VANTHO15/Drone_ThuyetTrinh/Tài nguyên/003 BV máy tổng thể.pdf

Tỷ lệ: 1:2 THIẾT KẾ, CHẾ TẠO MÁY TRỢ THỞ PHỤC VỤ COVID-19 Hướng dẫn Thiết kế T.Nhiệm Họ và tên Ngày Ký ĐỒ ÁN TỐT NGHIỆP Khối lượng: Tờ số: 5 Số tờ: Duyệt Hồ Hữu Bền TS. Hoàng Văn Thạnh Phạm Hồng Vinh TT Ký hiệu Tên gọi Số lượng Klg Vật liệu Ghi chú 0102030405 Nút nguồn Nút điều khiển Đèn tín hiệu KHOA CƠ KHÍ - LỚP 16C1A BẢN VẼ MÁY 12 3 4 5 6 7 0607 Ống nối thở ra Ống nối hít vào 8 08 Ống nối nguồn khí Oxy 0103020501010101 Volume điều chỉnh Van PEEP 370 280

### 300 TRƯỜNG ĐHBK- ĐH ĐÀ NẴNG 6 PGS.TS. Lưu Đức Bình

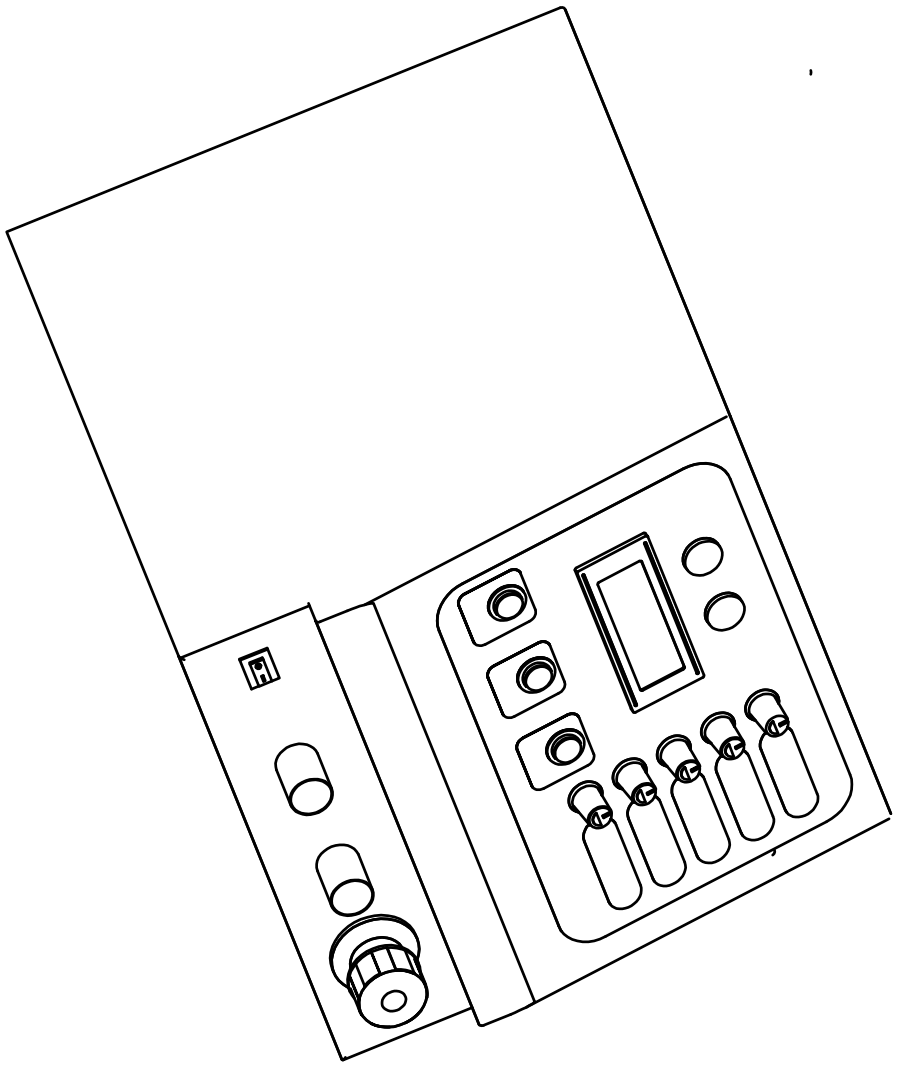
[picture p47: figure]
