VANTHO15/Drone_ThuyetTrinh/Tài nguyên/005 BV lắp.pdf

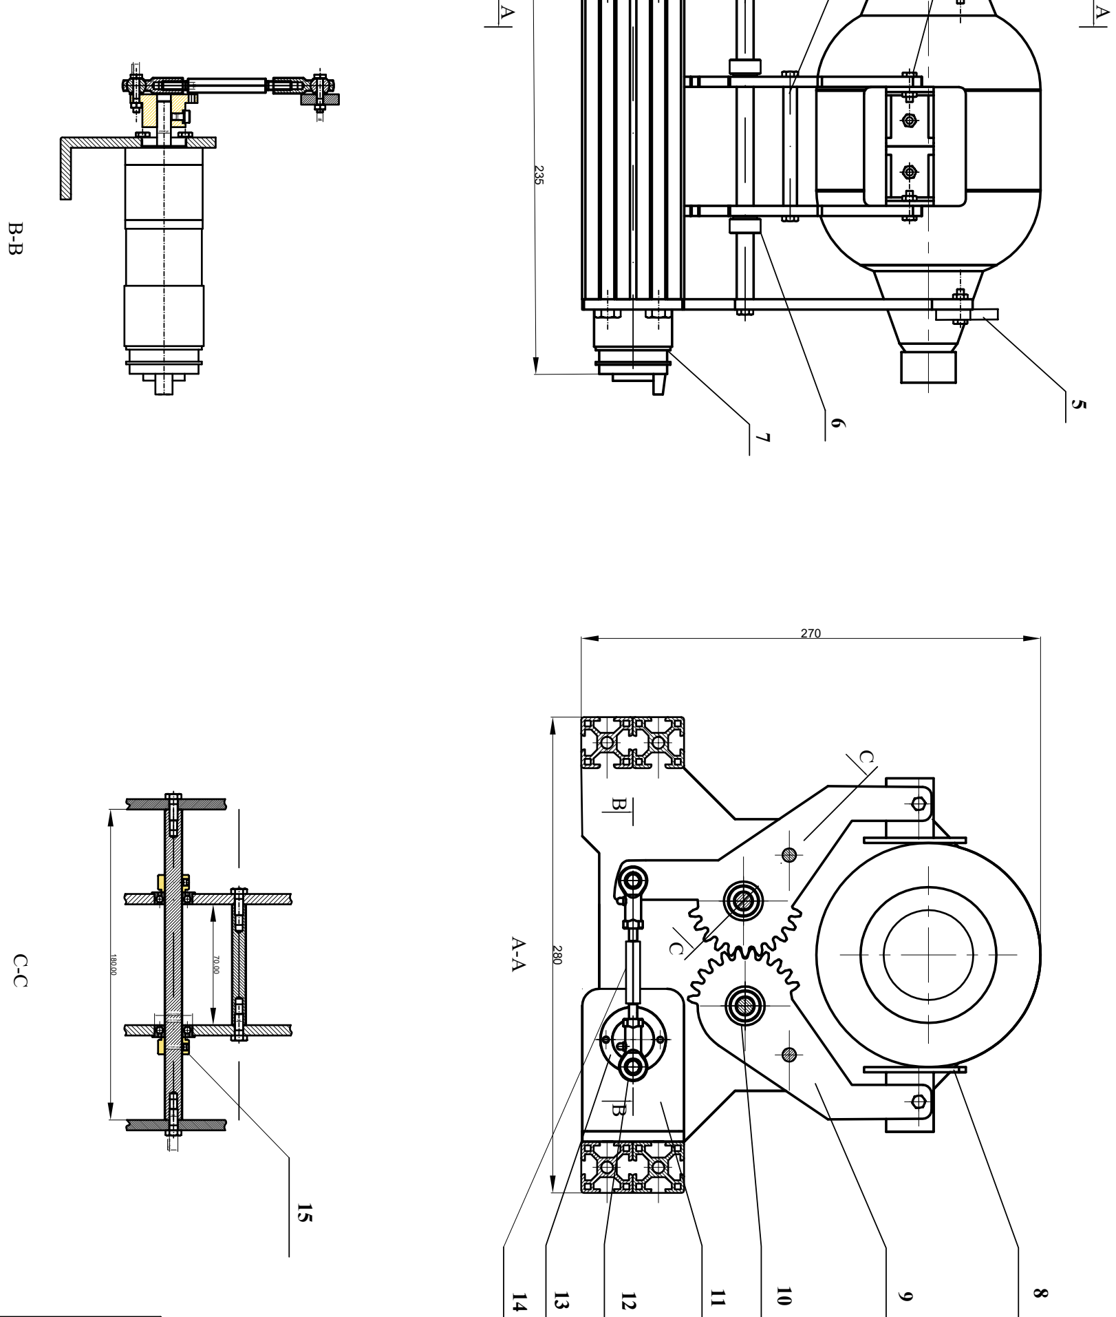
[picture p48: figure]

A-A Tỷ lệ: 1:1 THIẾT KẾ, CHẾ TẠO MÁY TRỢ THỞ PHỤC VỤ COVID-19 Hướng dẫn Thiết kế T.Nhiệm Họ và tên Ngày Ký ĐỒ ÁN TỐT NGHIỆP Khối lượng: Tờ số: 4 Số tờ: Duyệt Hồ Hữu Bền TS. Hoàng Văn Thạnh Phạm Hồng Vinh TT Ký hiệu Tên gọi Số lượng Klg Vật liệu Ghi chú 0102030405 Má bóp Mặt bích KHOA CƠ KHÍ - LỚP 16C1A BẢN VẼ TỔNG THỂ Càng bóp Tấm kẹp Thanh truyền Vít M5 Khớp cầu Ổ lăn Trục ngắn Trục dài Giá đỡ động cơ 06070809101112131415 01 02040101 02 04120401 02 Nhôm Nhôm Thép Thép Thép Thép Thép Nhôm Thép Con chặn 04 Nhôm Động cơ 1

1
2

3

4

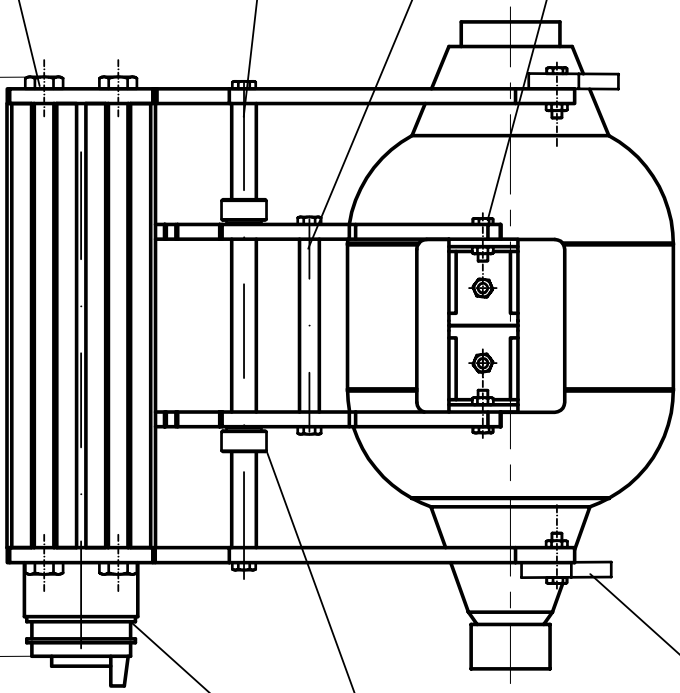
[picture p49: figure]

# 235 Vít M8 08 Thép Con chặn 04 Thép TRƯỜNG ĐHBK- ĐH ĐÀ NẴNG

# 6 PGS.TS. Lưu Đức Bình
