VANTHO15/Drone_ThuyetTrinh/(list of files, cad)

Other CAD files:
Tài nguyên/MachNguyenLyMayTho.dwg
Tài nguyên/00000001DATN.dwg
Tài nguyên/BẢN VẼ/BẢN VẼ/Bánh răng lớn.prt
Tài nguyên/BẢN VẼ/BẢN VẼ/Bánh răng nhỏ.prt
Tài nguyên/BẢN VẼ/BẢN VẼ/Gá mô tơ.prt
Tài nguyên/BẢN VẼ/BẢN VẼ/Khunglung.prt
Tài nguyên/BẢN VẼ/BẢN VẼ/Khunglungnho.prt
Tài nguyên/BẢN VẼ/BẢN VẼ/Lắp ráp.prt
Tài nguyên/BẢN VẼ/BẢN VẼ/Má bóp.prt
Tài nguyên/BẢN VẼ/BẢN VẼ/Mô tơ.prt
Tài nguyên/BẢN VẼ/BẢN VẼ/Nhom thanh.prt
Tài nguyên/BẢN VẼ/BẢN VẼ/con đỡ.prt
Tài nguyên/BẢN VẼ/BẢN VẼ/mặt bích.prt
Tài nguyên/BẢN VẼ/BẢN VẼ/thanh truyền.prt
Tài nguyên/BẢN VẼ/BẢN VẼ/truc ngăn.prt
Tài nguyên/BẢN VẼ/BẢN VẼ/trục dài.prt
Tài nguyên/BẢN VẼ/BẢN VẼ/vít M4.prt
Tài nguyên/BẢN VẼ/BẢN VẼ/vít m5.prt
Tài nguyên/Tải về/BẢN VẼ/Bánh răng lớn.prt
Tài nguyên/Tải về/BẢN VẼ/Bánh răng nhỏ.prt
Tài nguyên/Tải về/BẢN VẼ/File lung sau sửa.prt
Tài nguyên/Tải về/BẢN VẼ/File lưng 2 sau sửa.prt
Tài nguyên/Tải về/BẢN VẼ/Gá mô tơ.prt
Tài nguyên/Tải về/BẢN VẼ/Lắp ráp 01.prt
Tài nguyên/Tải về/BẢN VẼ/Má bóp.prt
Tài nguyên/Tải về/BẢN VẼ/Mô tơ.prt
Tài nguyên/Tải về/BẢN VẼ/Nhom thanh.prt
Tài nguyên/Tải về/BẢN VẼ/con đỡ.prt
Tài nguyên/Tải về/BẢN VẼ/mặt bích.prt
Tài nguyên/Tải về/BẢN VẼ/thanh truyền.prt
Tài nguyên/Tải về/BẢN VẼ/truc ngăn.prt
Tài nguyên/Tải về/BẢN VẼ/trục dài.prt
Tài nguyên/Tải về/BẢN VẼ/vít M4.prt
Tài nguyên/Tải về/BẢN VẼ/vít m5.prt
