VANTHO15/Drone_ThuyetTrinh/Tài nguyên/06 BV mạch điều khiển.pdf

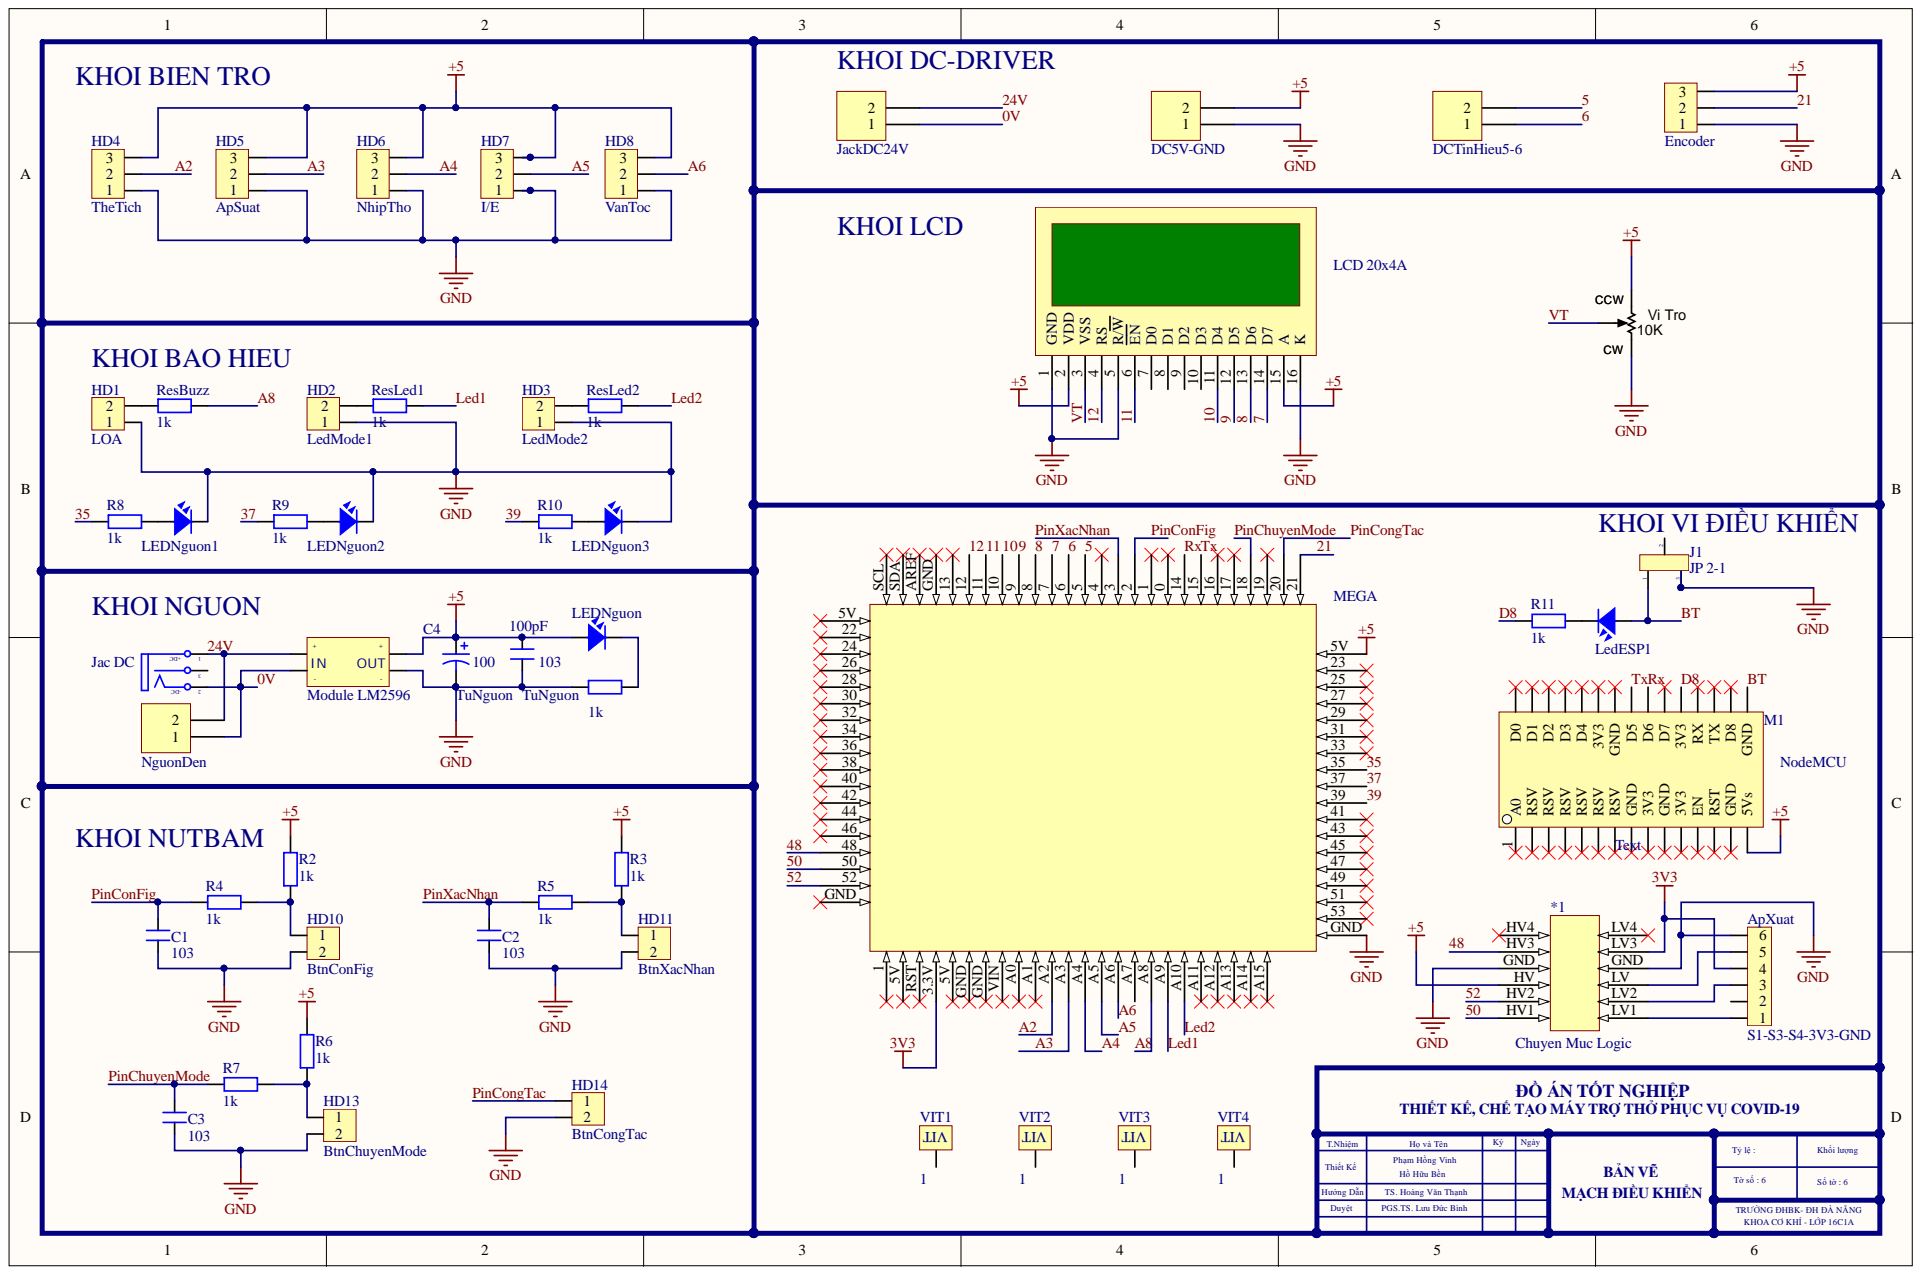
[picture p50: page 1]

KHOI VI ĐIỀU KHIỂN

GND | GND
HV | LV

ĐỒ ÁN TỐT NGHIỆP THIẾT KẾ, CHẾ TẠO MÁY TRỢ THỞ PHỤC VỤ COVID-19

TS. Hoàng Văn Thạnh

Duyệt | PGS.TS. Lưu Đức Bình | TRƯỜNG ĐHBK- ĐH ĐÀ NẴNG KHOA CƠ KHÍ - LỚP 16C1A
