VANTHO15/Drone_ThuyetTrinh/Tài nguyên/001 Bản vẽ chế tạoo.pdf

Ø4⁺⁰.1 19

160

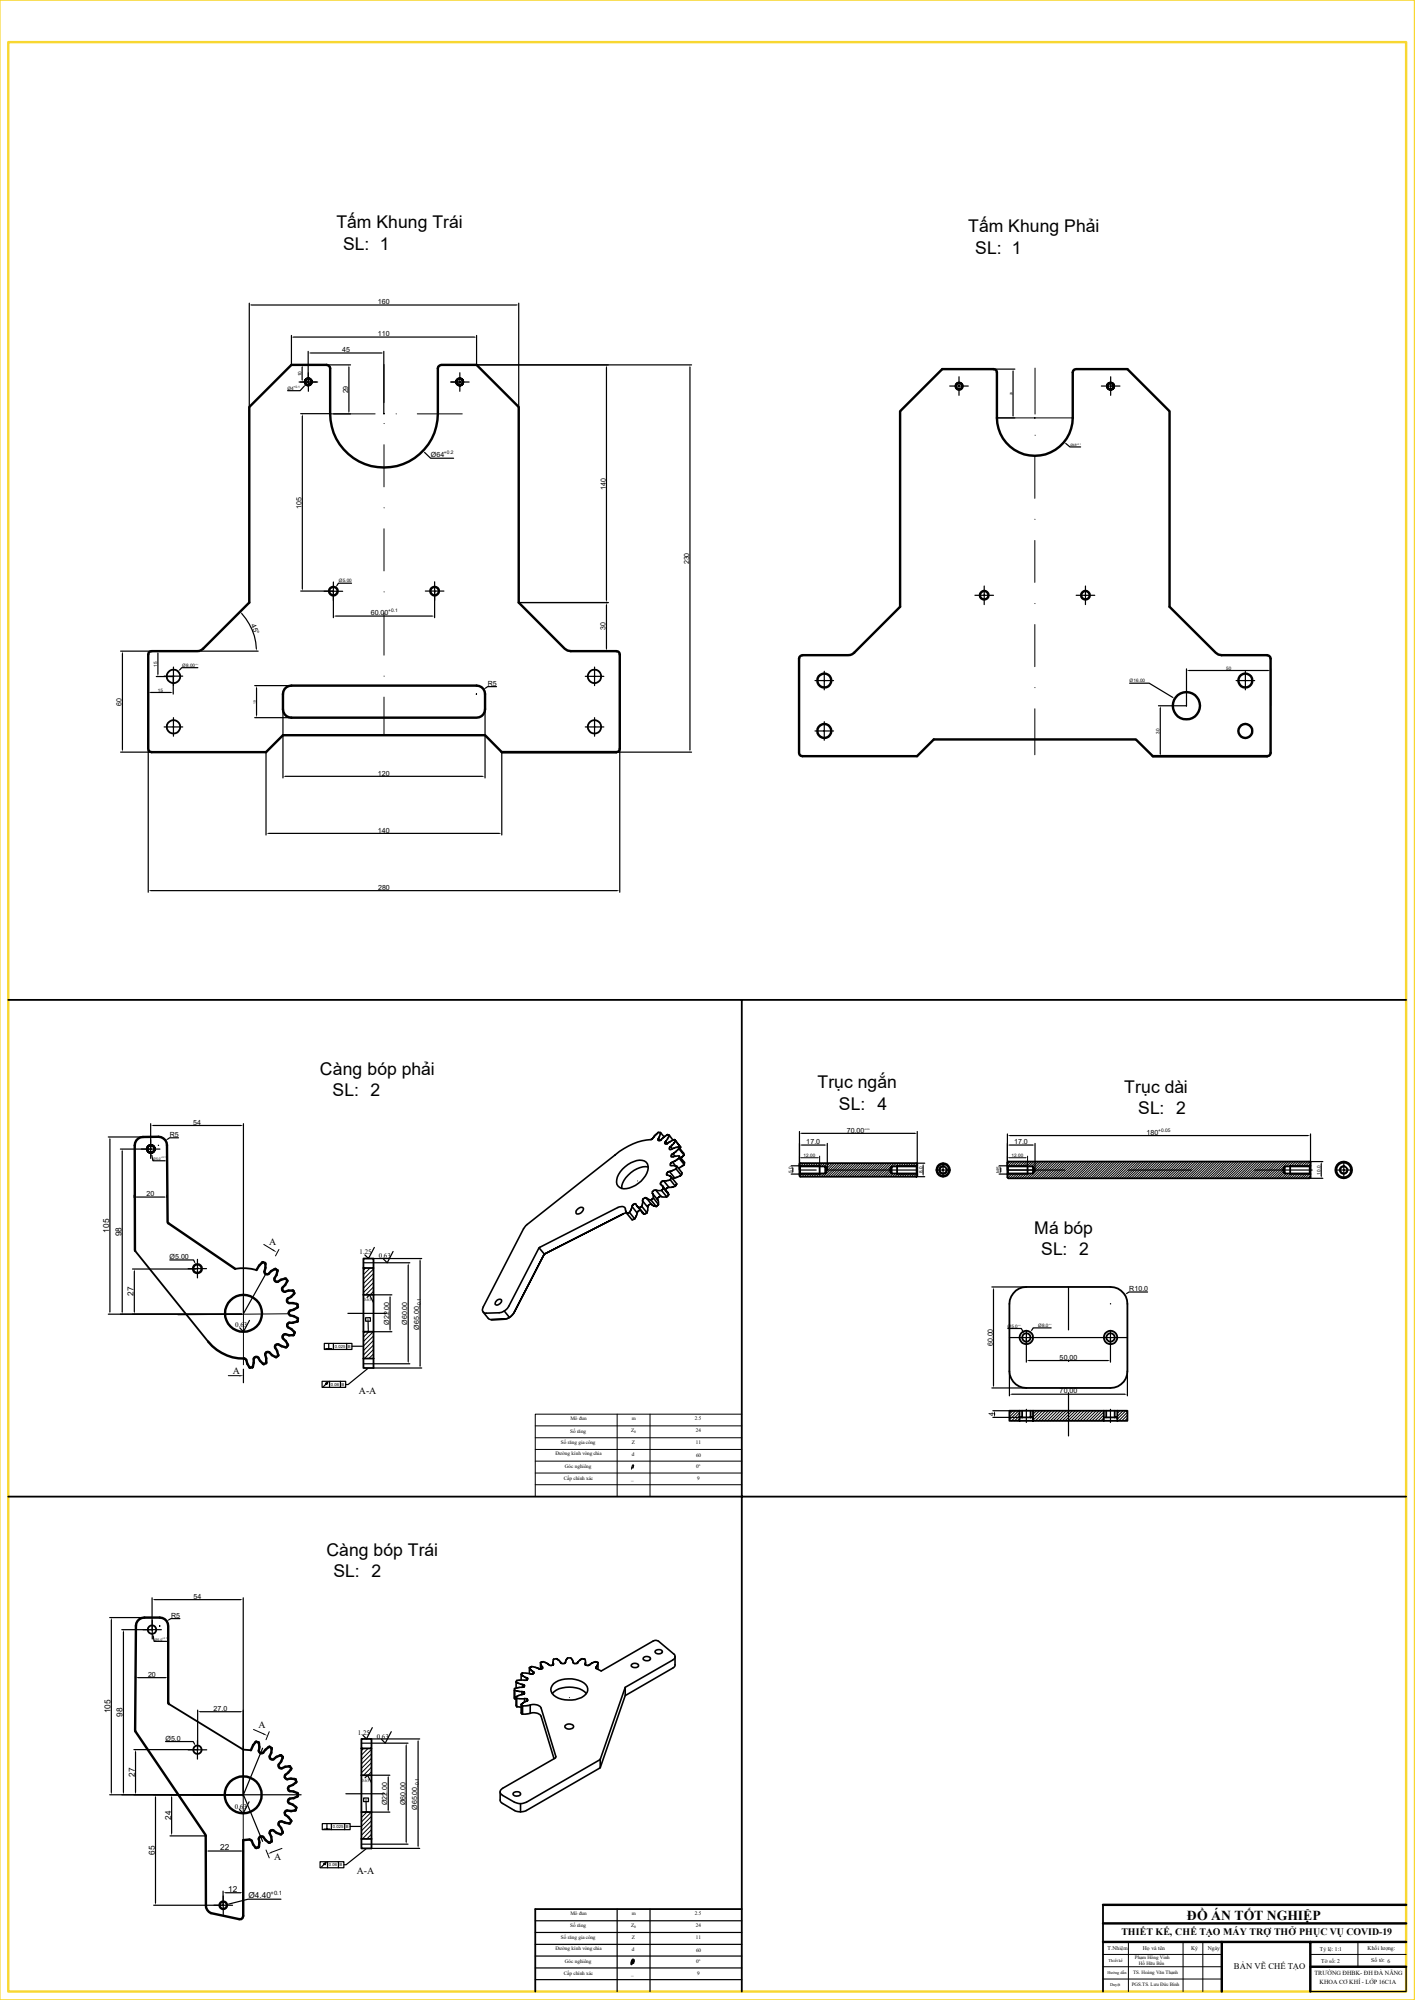
[picture p51: page 1]
Mô đun; Góc nghiêng; Ø⁶⁰.00; Ø⁶⁵.00⁻⁰.1 A-A; Trục ngắn SL: 4; Trục dài SL: 2; Má bóp SL: 2; Ø⁶⁵.00⁻⁰.1 A-A ⁹⁸; 0.63 A ⁶⁵ 0.63 Ø²².00; T.Nhiệm; Hướng dẫn; Thiết kế; Họ và tên; Ngày ĐỒ ÁN TỐT NGHIỆP; Khối lượng:; Duyệt

Tấm Khung Trái

Tấm Khung Phải

Càng bóp phải

0.63 Ø²².00

Số răng
Số răng gia công

Đường kính vòng chia

Cấp chính xác

Càng bóp Trái

Tỷ lệ: 1:1 THIẾT KẾ, CHẾ TẠO MÁY TRỢ THỞ PHỤC VỤ COVID-19

Phạm Hồng Vinh
Hồ Hữu Bền
TS. Hoàng Văn Thạnh

KHOA CƠ KHÍ - LỚP 16C1A BẢN VẼ CHẾ TẠO

TRƯỜNG ĐHBK- ĐH ĐÀ NẴNG

PGS.TS. Lưu Đức Bình
