VANTHO15/Drone_ThuyetTrinh/Tài nguyên/002 bản vẽ phương án thiết kế.pdf

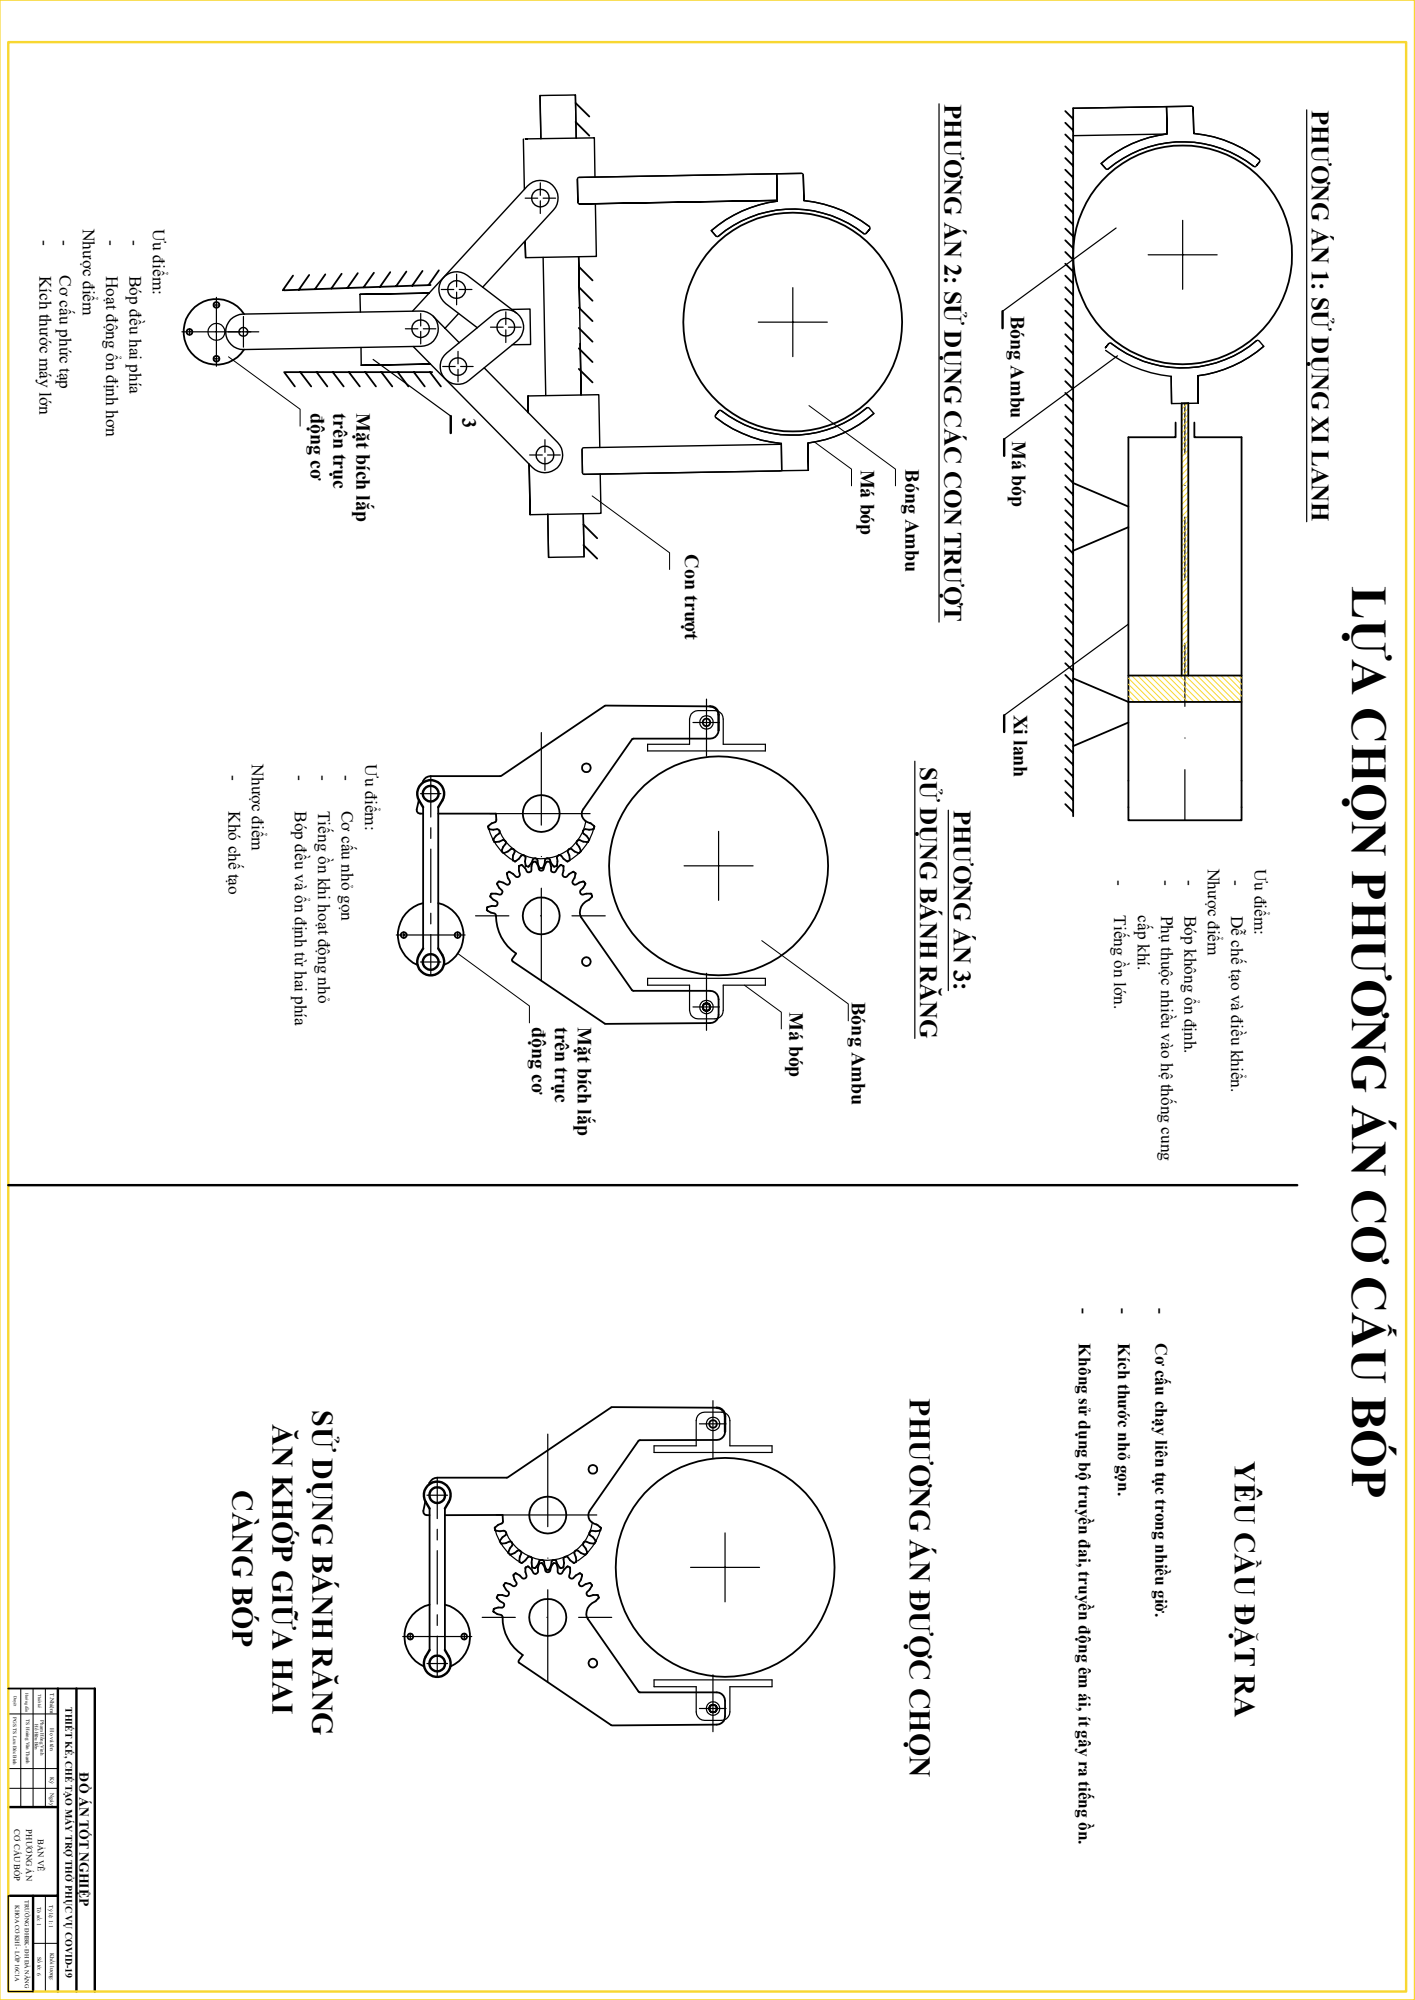
[picture p52: page 1]

Tỷ lệ: 1:1 THIẾT KẾ, CHẾ TẠO MÁY TRỢ THỞ PHỤC VỤ COVID-19 Hướng dẫn Thiết kế T.Nhiệm Họ và tên Ngày Ký ĐỒ ÁN TỐT NGHIỆP Khối lượng: Tờ số: 1 Số tờ: Duyệt Hồ Hữu Bền TS. Hoàng Văn Thạnh Phạm Hồng Vinh TRƯỜNG ĐHBK- ĐH ĐÀ NẴNG KHOA CƠ KHÍ - LỚP 16C1A BẢN VẼ CƠ CẤU BÓP PHƯƠNG ÁN - Không sử dụng bộ truyền đai, truyền động êm ái, ít gây ra tiếng ồn. - Kích thước nhỏ gọn. - Cơ cấu chạy liên tục trong nhiều giờ. YÊU CẦU ĐẶT RA PHƯƠNG ÁN 3: SỬ DỤNG BÁNH RĂNG PHƯƠNG ÁN 2: SỬ DỤNG CÁC CON TRƯỢT PHƯƠNG ÁN ĐƯỢC CHỌN Ưu điểm: - Dễ chế tạo và điều khiển. Nhược điểm - Phụ thuộc nhiều vào hệ thống cung - Bóp không ổn định. cấp khí. - Tiếng ồn lớn. Ưu điểm: - Hoạt động ổn định hơn - Bóp đều hai phía Nhược điểm - Kích thước máy lớn - Cơ cấu phức tạp Ưu điểm: - Bóp đều và ổn định từ hai phía - Tiếng ồn khi hoạt động nhỏ - Cơ cấu nhỏ gọn Nhược điểm - Khó chế tạo PHƯƠNG ÁN 1: SỬ DỤNG XI LANH Bóng Ambu Má bóp Con trượt Mặt bích lắp 3động cơ trên trục động cơ trên trục Mặt bích lắp LỰA CHỌN PHƯƠNG ÁN CƠ CẤU BÓP Xi lanh Bóng Ambu Bóng Ambu Má bóp Má bóp SỬ DỤNG BÁNH RĂNG ĂN KHỚP GIỮA HAI CÀNG BÓP 6 PGS.TS. Lưu Đức Bình
