VANTHO15/Drone_ThuyetTrinh/(list of files, drawings)

Other design files:
Tài nguyên/Sheet1.schdoc
